Nobcha/ARD_LCM_MANUAL/LCM7_2_schematic.jpg

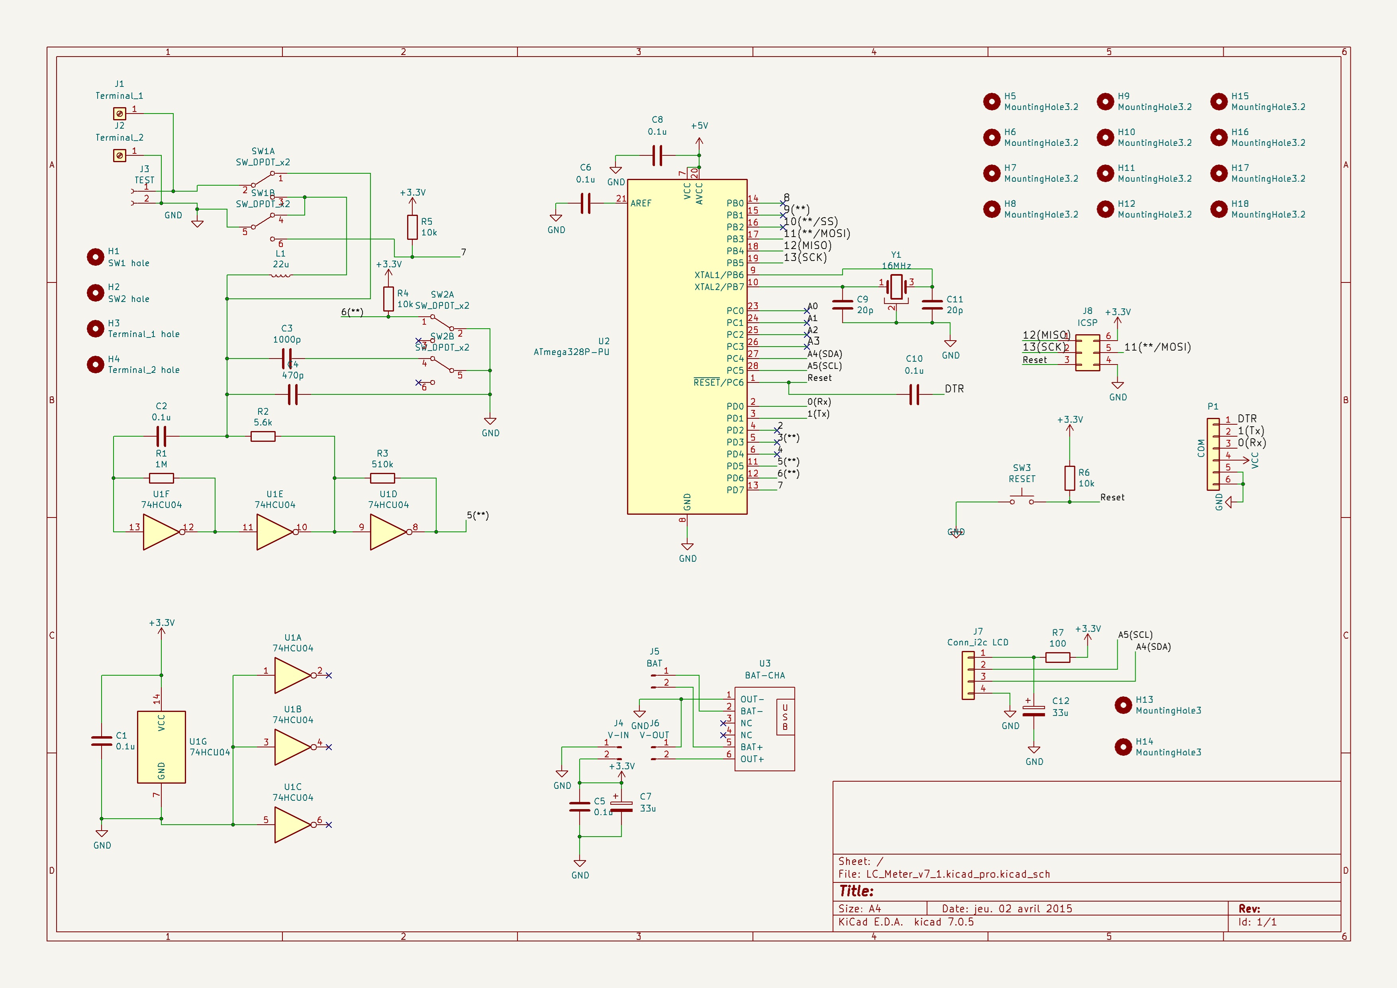
LCM7_2_schematic.jpg
