Nobcha/ARD_LCM_MANUAL/LCM7_2_TP4056.jpg

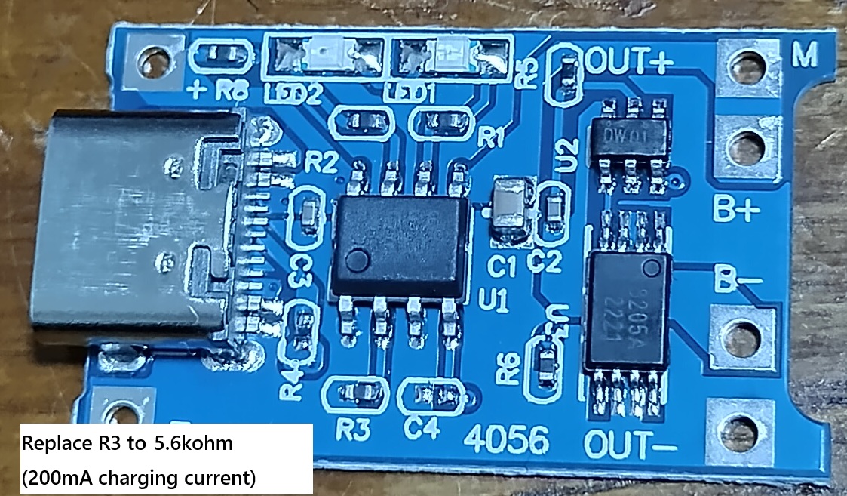
LCM7_2_TP4056.jpg
