Nobcha/ARD_LCM_MANUAL/LCM7_2PCB_3D.jpg

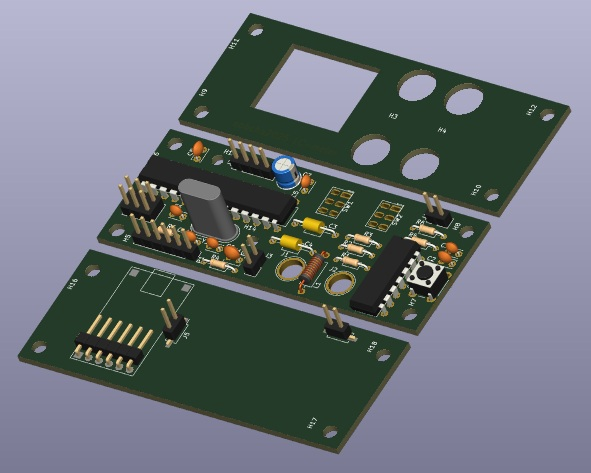
LCM7_2PCB_3D.jpg
