Nobcha/ARD_LCM_MANUAL/LCM V7 Mistake prevention list.jpg

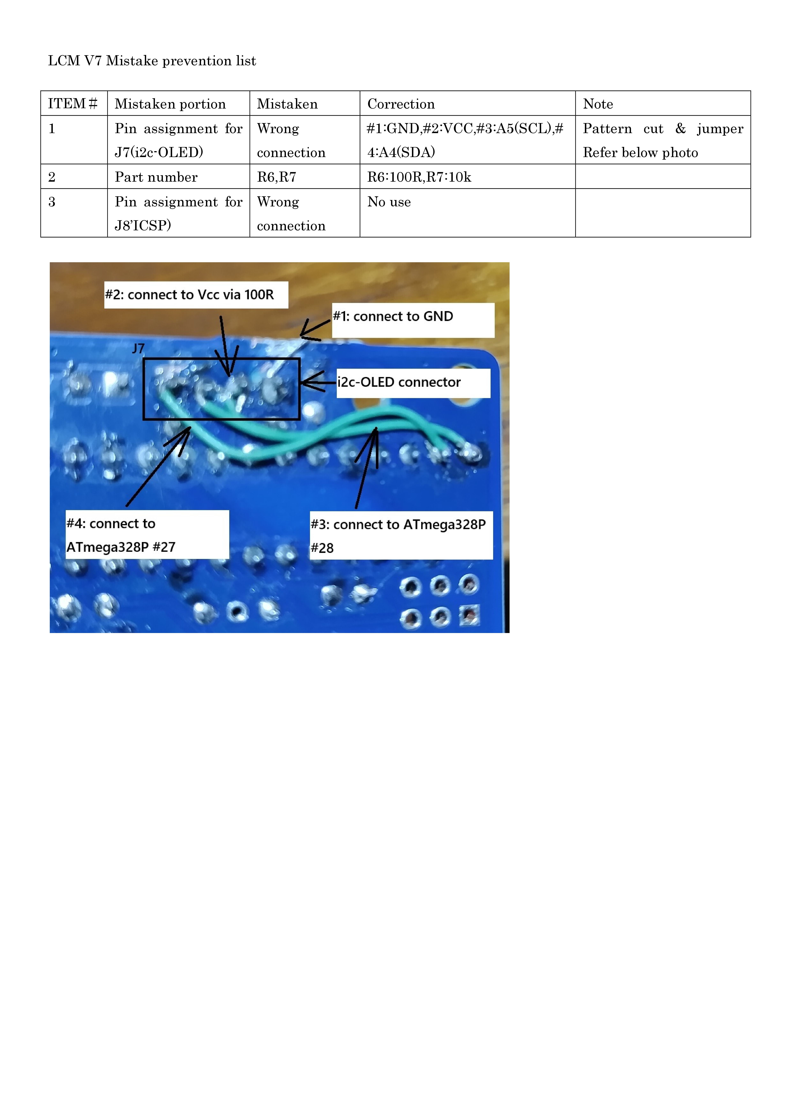
LCM V7 Mistake prevention list.jpg
