Nobcha/ARD_LCM_MANUAL/LCMV7_BOM1_ja.jpg

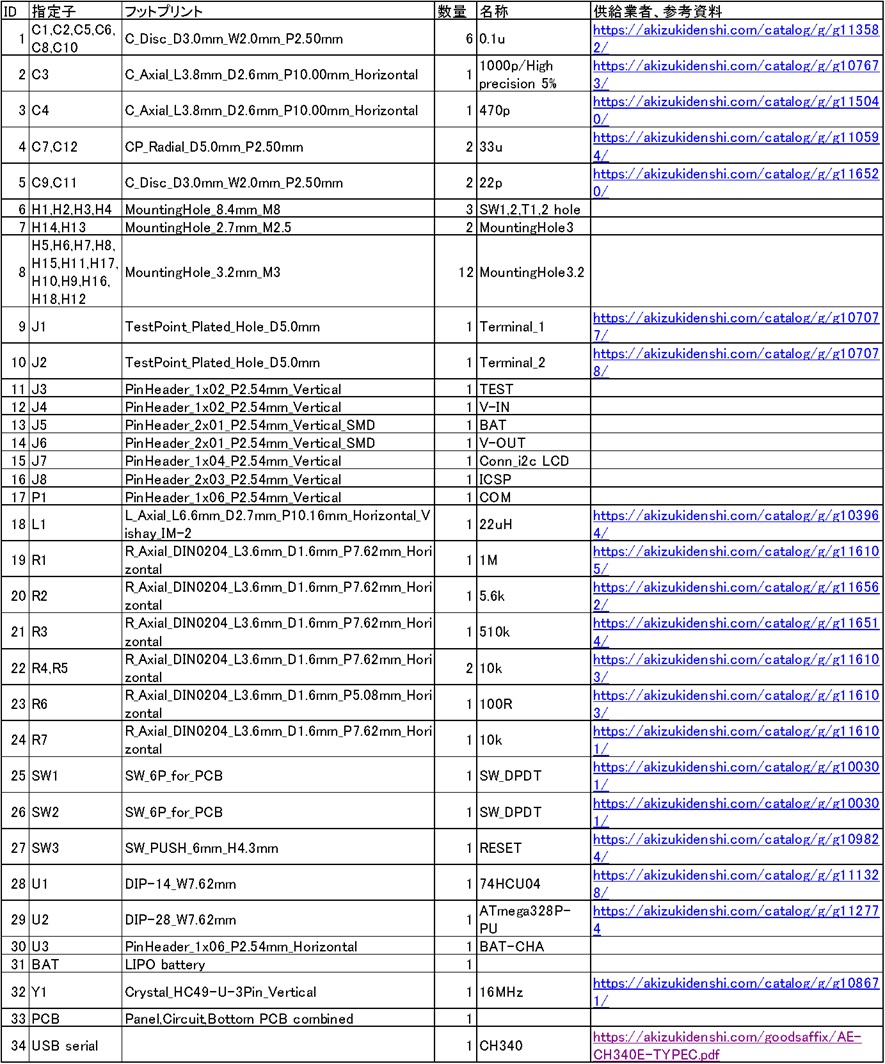
LCMV7_BOM1_ja.jpg
