Nobcha/ARD_LCM_MANUAL/(commit log)

2025-11-22 Expand README with LC meter assembly information
    Added details about the manual calibration LC meter and its capabilities for measuring inductance.
2025-11-22 PCB information
    LCM7_2PCB_3D.jpg: 3D data as assembled
    LCM7_2PCB.jpg: the schematic diagram
2025-11-22 Schematic diagram
2025-12-15 Revise README for clarity and corrections
    Updated the README to clarify the purpose and features of the Franklin oscillator LC meter, including details on calibration and circuit errors.
2025-12-16 Assembly and instruction manual
    Manual
2025-12-16 Gerber zip
2026-02-02 Manual for Japanese
    The assembly and instruction manual for Japanese.
2026-02-07 Educational version for sketch .ino
    I shrank the sketch as lower than 80％/60％.
2026-02-07 The latest
    Change the small bugs
